Andrew-InTheBox/PhotonBatteryManagement/readme.md

## Overview

This project uses a four-forty 12S BMS board and a particle photon as a BMS for a 12S lithium ion battery. Included in the project are the following features:

 - isolation of low from high voltage systems
 - web connectivity (not fully implemented but hardware supported)
 - current measuring
 - cell level voltage monitoring
 - low and high voltage cutoff
 - 30A maximum current rating (depends on relay used)
## Parts list
 - http://four-forty.com/product/12s-battery-monitoring-board-2/
 - https://store.particle.io/  (particle photon model)
 - https://www.digikey.com/product-detail/en/panasonic-electric-works/AHES3190/255-5227-ND/5352930 (or other 100+V/30A relay switchable at 5V)
 - http://four-forty.com/product/30a-inline-current-sensor/ 
 - 500mA fuses for sense wires, 30A fuse for load circuit
 - SPST switches of your choosing
 - LCA710 optofets (2)
 - 48V to 5V DC switching supply (to power photon from battery)
 - terminal block (30A or higher rating)
 ## Useful to have
 - multi-meter
 - soldering iron
 - benchtop lab power supply
 - FTDI usb to serial
