Andrew-InTheBox/PhotonBatteryManagement/Schematic.pdf

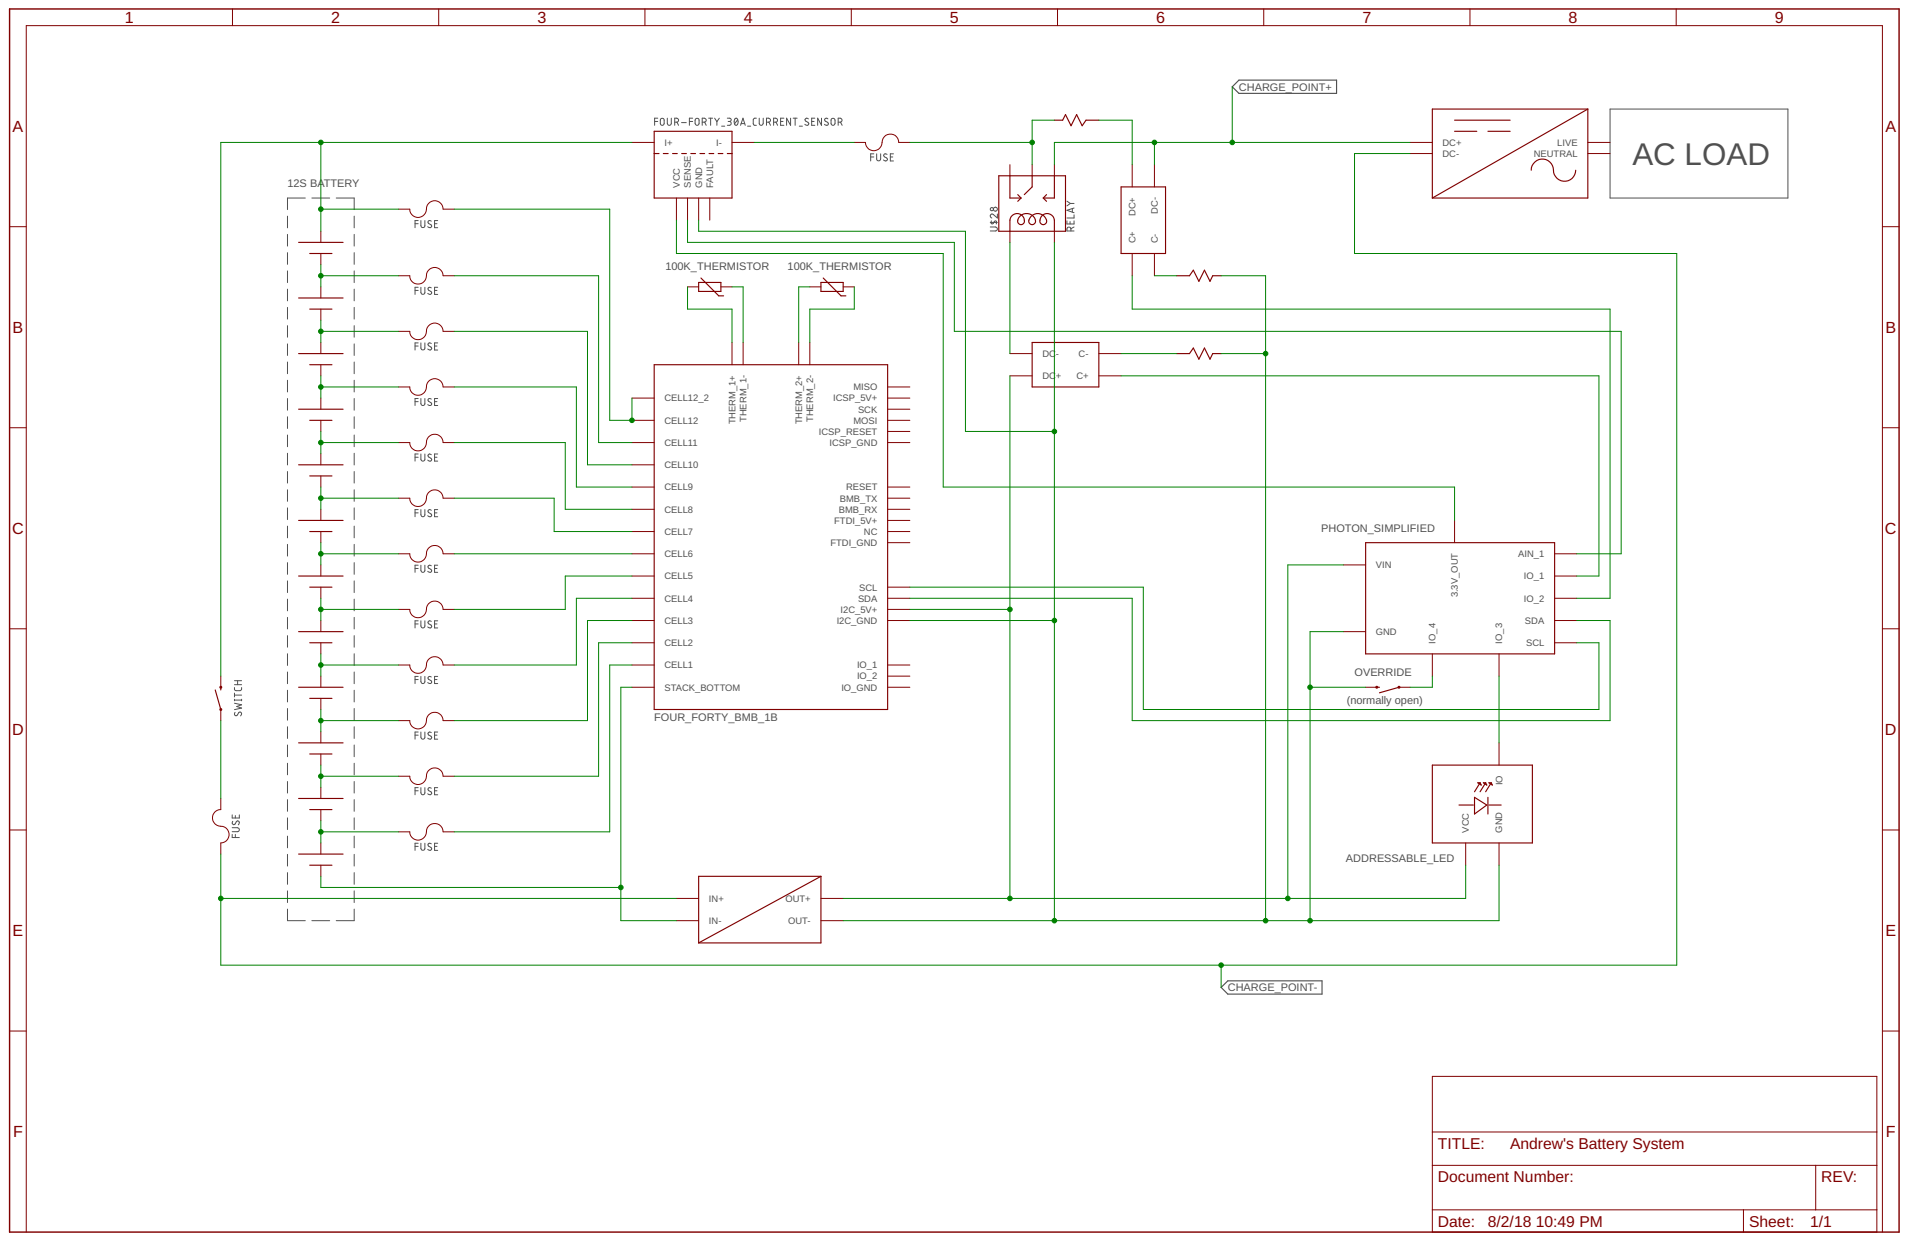
[picture p1: page 1]

REV: TITLE: Document Number: Andrew's Battery System

Date: 8/2/18 10:49 PM | Sheet: 1/1
