Andrew-InTheBox/PhotonBatteryManagement/(commit log)

2018-04-17 Add temp sensor reading
2018-07-23 Fix bug with finding bad cell voltage. Add RGB LED support.
2018-08-12 Add schematic
2018-09-23 Use semi-automatic offline mode. Adjust low voltege cutoff setting
2019-03-16 Fix offline mode functionality
    [PhotonCode_v2.ino]
